Markus-Seitz-OpenBot24/Ampelsteuerung_ET2/Bilder/Image (9).jpg

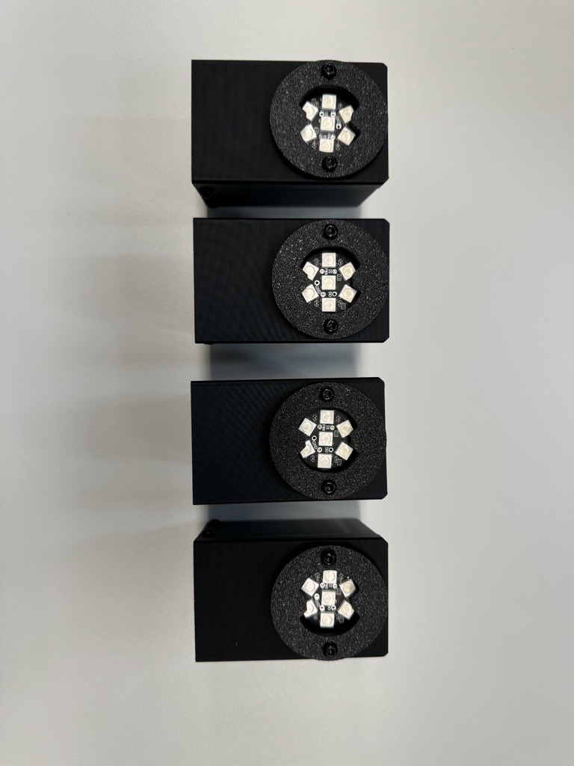
Bilder/Image (9).jpg
