Markus-Seitz-OpenBot24/Ampelsteuerung_ET2/Bilder/Image (19).jpg

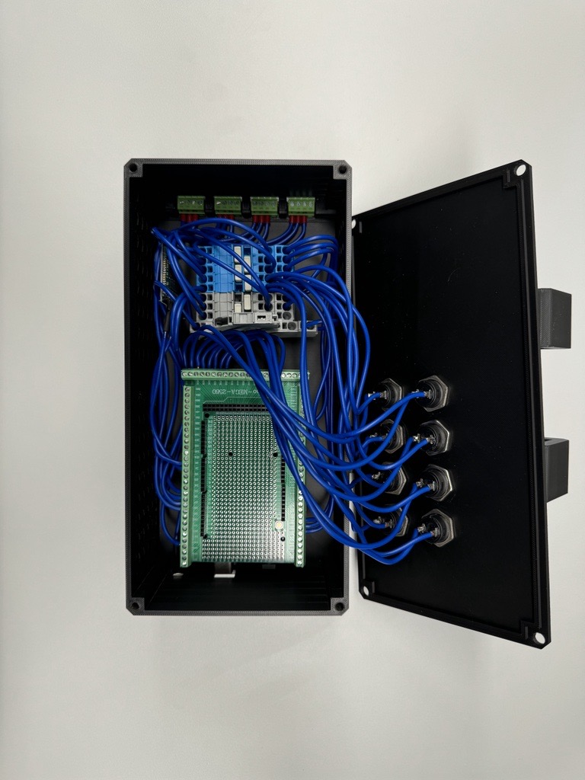
Bilder/Image (19).jpg
