Markus-Seitz-OpenBot24/Ampelsteuerung_ET2/Android_App/ReadME.txt

+ Um die App zur Steuerung der Ampeln nutzen zu können musst du dich zuerst mit dem HC-05 Modul koppeln.

-> hierzu einfach Bluetooth einschalten und nach HC-05 Modul suchen -> zum Koppeln darauf tippen...

+ Jetzt die App öffnen und auf "BT Verbindungen verwalten" klicken

-> HC-05 Modul wählen -> App verbindet sich mit dem Modul

+ Congrats! Jetzt kannst du die Ampeln mit der App steuern!
