Markus-Seitz-OpenBot24/Ampelsteuerung_ET2/Anhang_Ampelsteuerung/Schaltplan/Schaltplan_Ampelsteuerung_Arduino.png

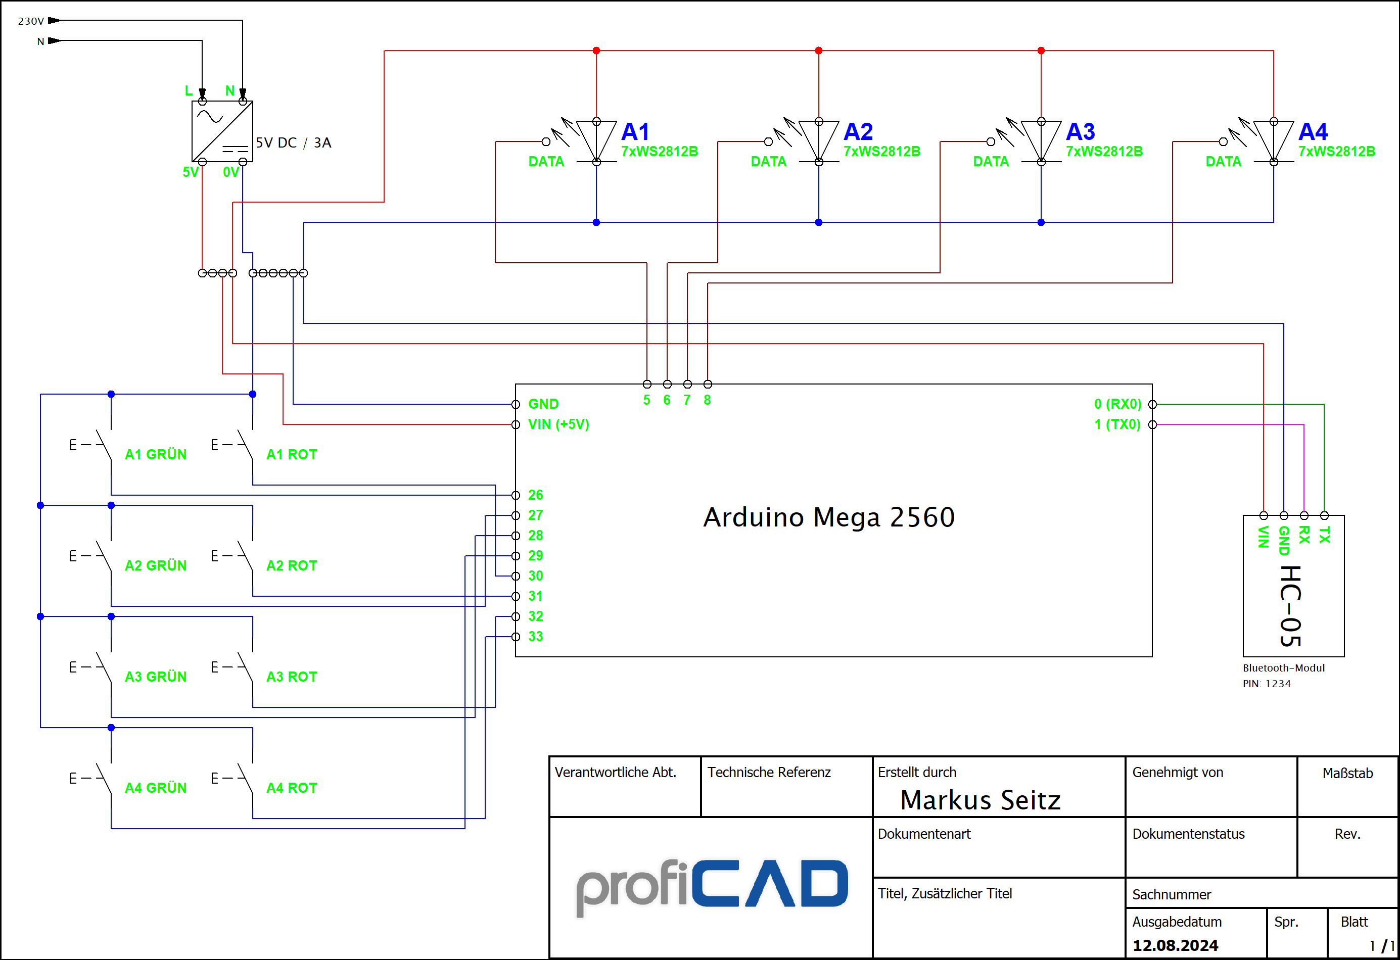
Anhang_Ampelsteuerung/Schaltplan/Schaltplan_Ampelsteuerung_Arduino.png
