Markus-Seitz-OpenBot24/Ampelsteuerung_ET2/Bilder/Ampel.png

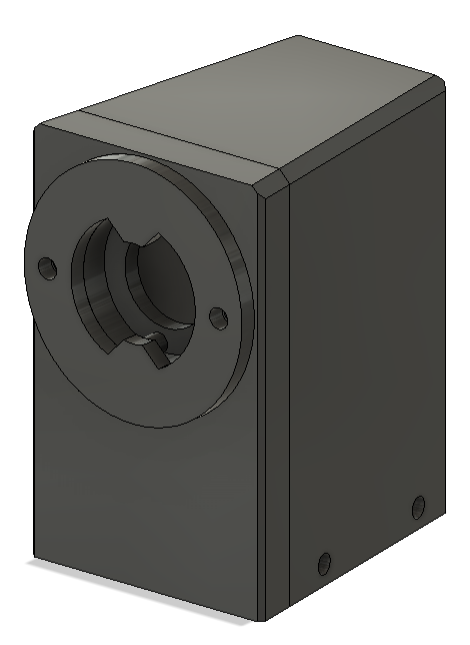
Bilder/Ampel.png
