Markus-Seitz-OpenBot24/Ampelsteuerung_ET2/Bilder/Ampelsteuerung Zeitmanagement/Ampelsteuerung Zeitmanagement_1.png

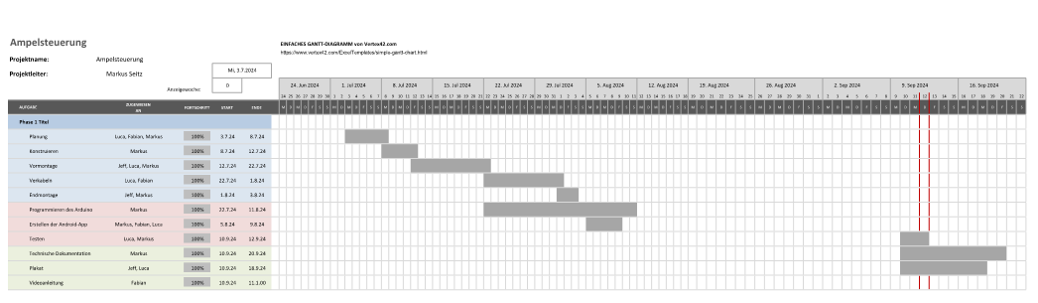
Bilder/Ampelsteuerung Zeitmanagement/Ampelsteuerung Zeitmanagement_1.png
