Markus-Seitz-OpenBot24/Ampelsteuerung_ET2/Bilder/Image (4).jpg

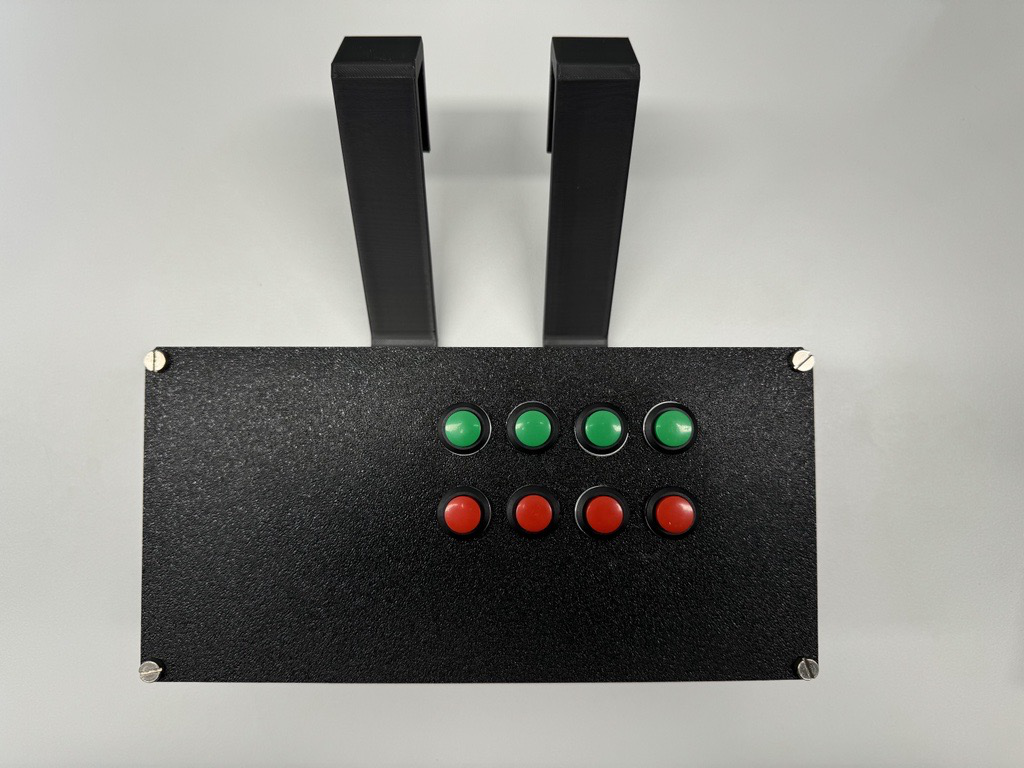
Bilder/Image (4).jpg
