Markus-Seitz-OpenBot24/Ampelsteuerung_ET2/Bilder/Image (8).jpg

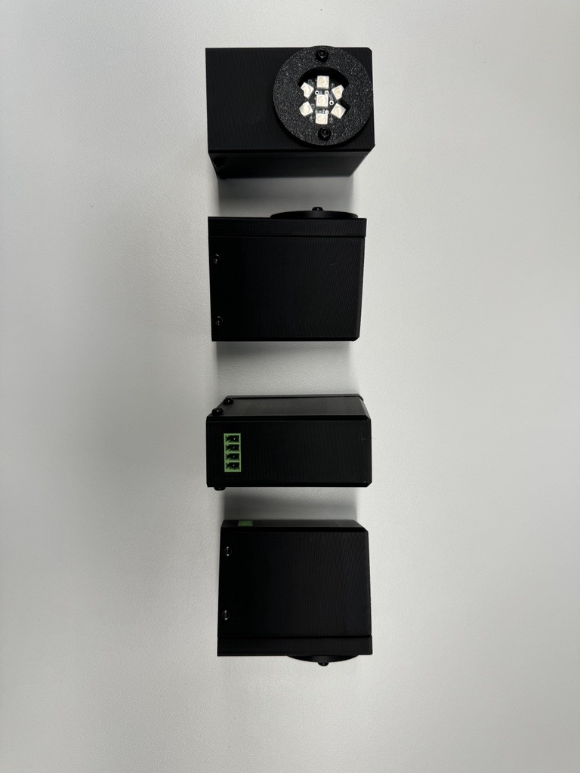
Bilder/Image (8).jpg
