Markus-Seitz-OpenBot24/Ampelsteuerung_ET2/Bilder/Image (11).jpg

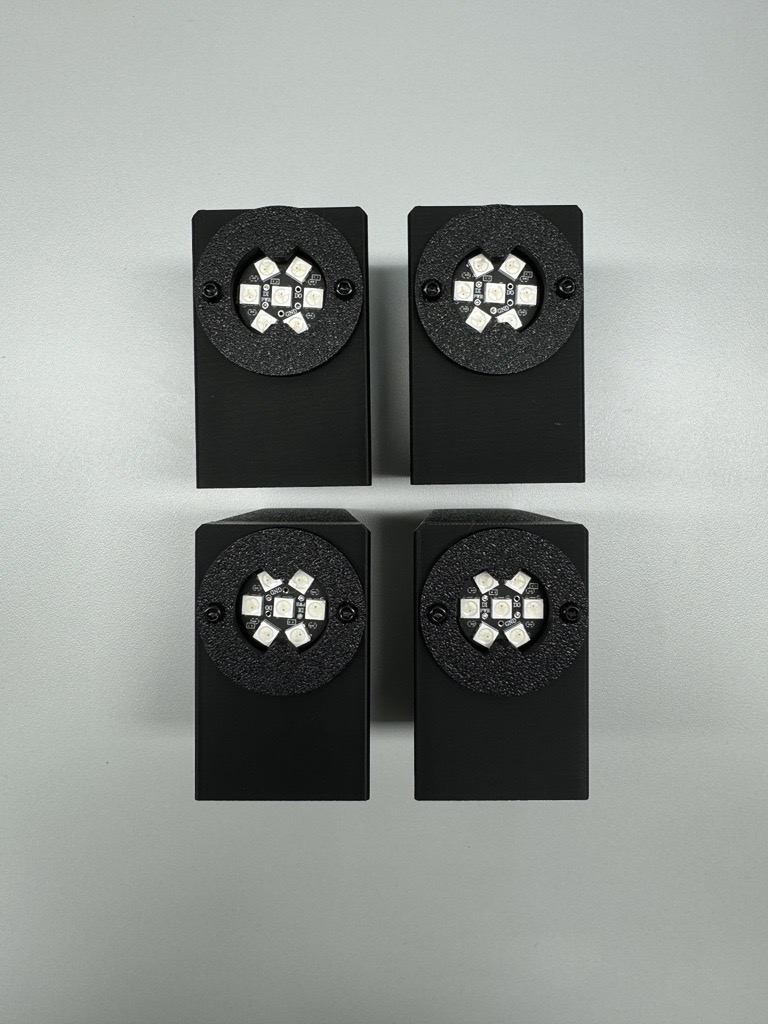
Bilder/Image (11).jpg
