Markus-Seitz-OpenBot24/Ampelsteuerung_ET2/Bilder/Image (13).jpg

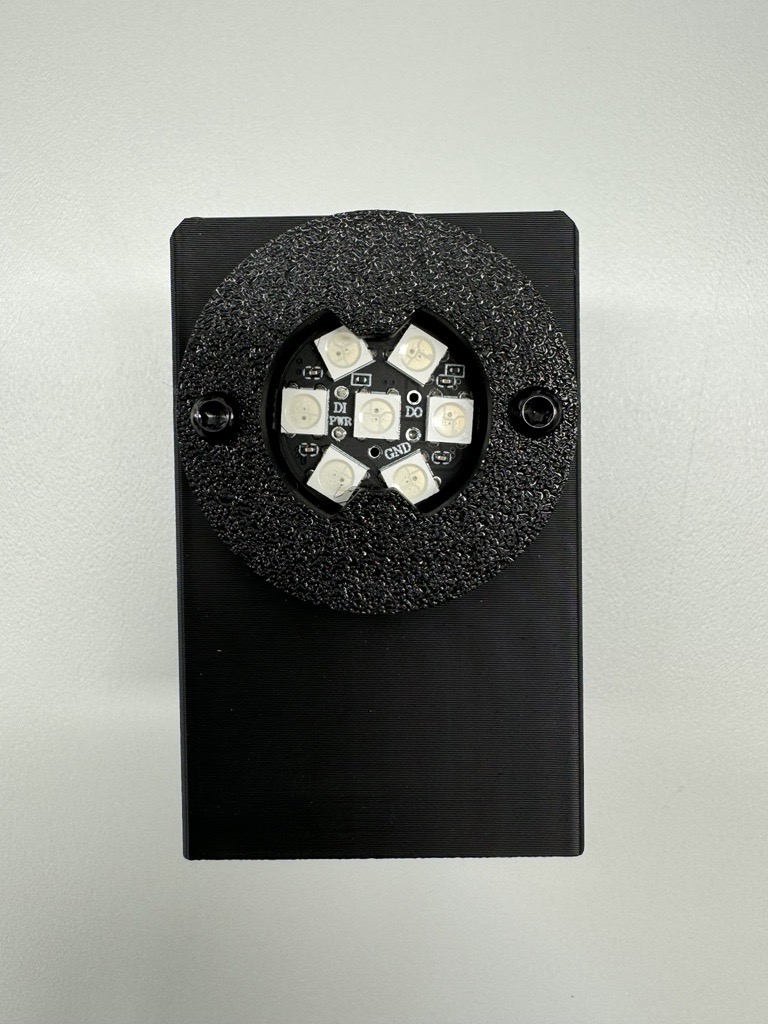
Bilder/Image (13).jpg
