Markus-Seitz-OpenBot24/Ampelsteuerung_ET2/Bilder/Image (18).jpg

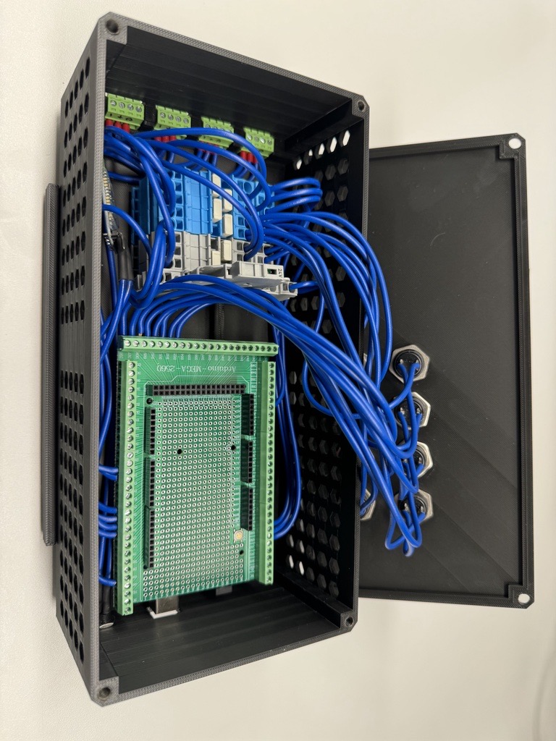
Bilder/Image (18).jpg
