Markus-Seitz-OpenBot24/Ampelsteuerung_ET2/Bilder/Image (20).jpg

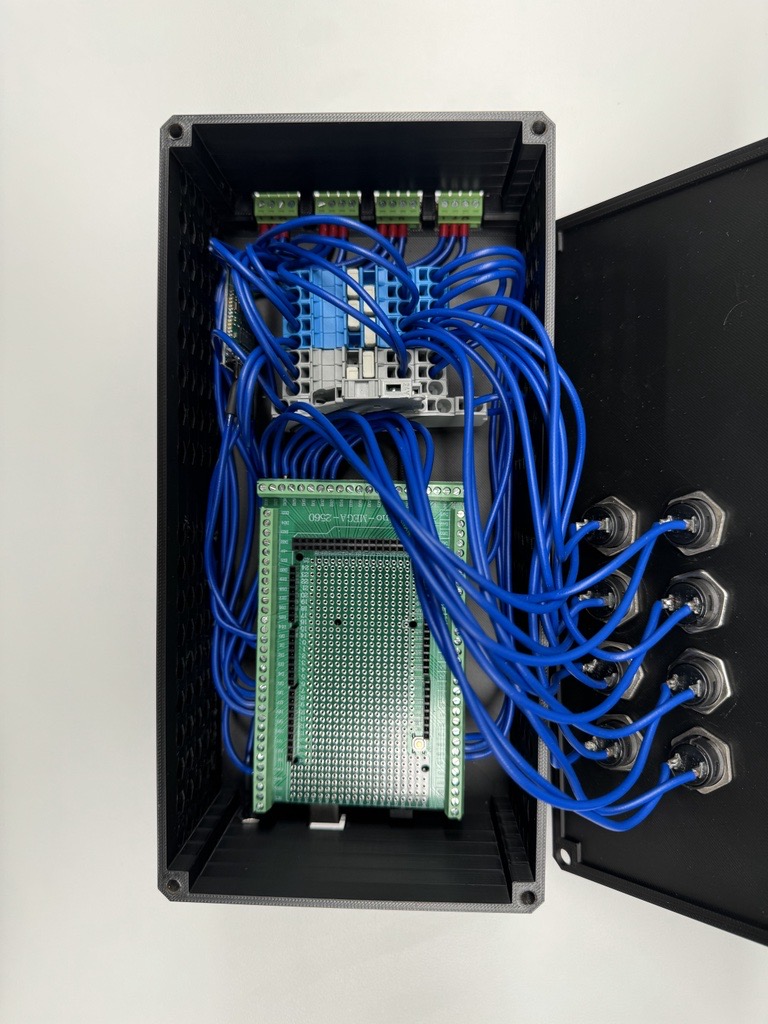
Bilder/Image (20).jpg
