Markus-Seitz-OpenBot24/Ampelsteuerung_ET2/Bilder/Image (21).jpg

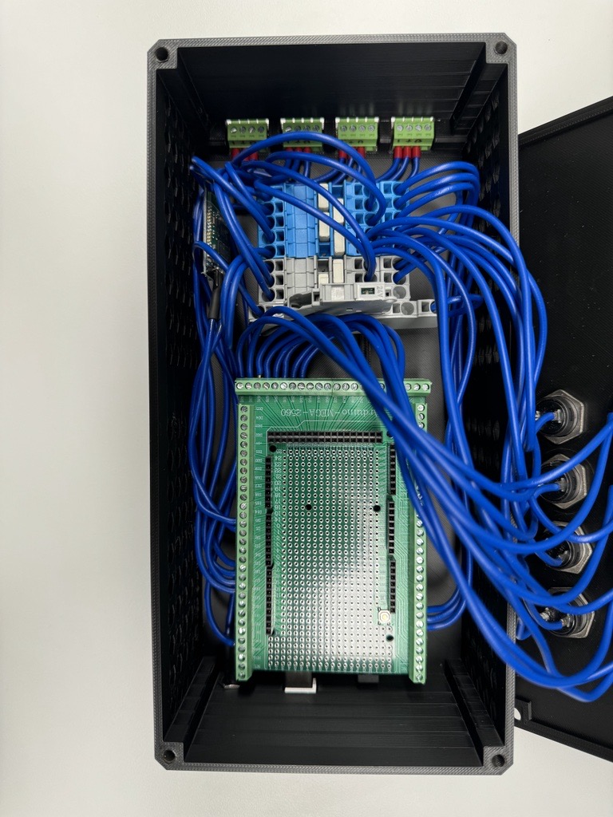
Bilder/Image (21).jpg
