Markus-Seitz-OpenBot24/Ampelsteuerung_ET2/Bilder/Image (28).jpg

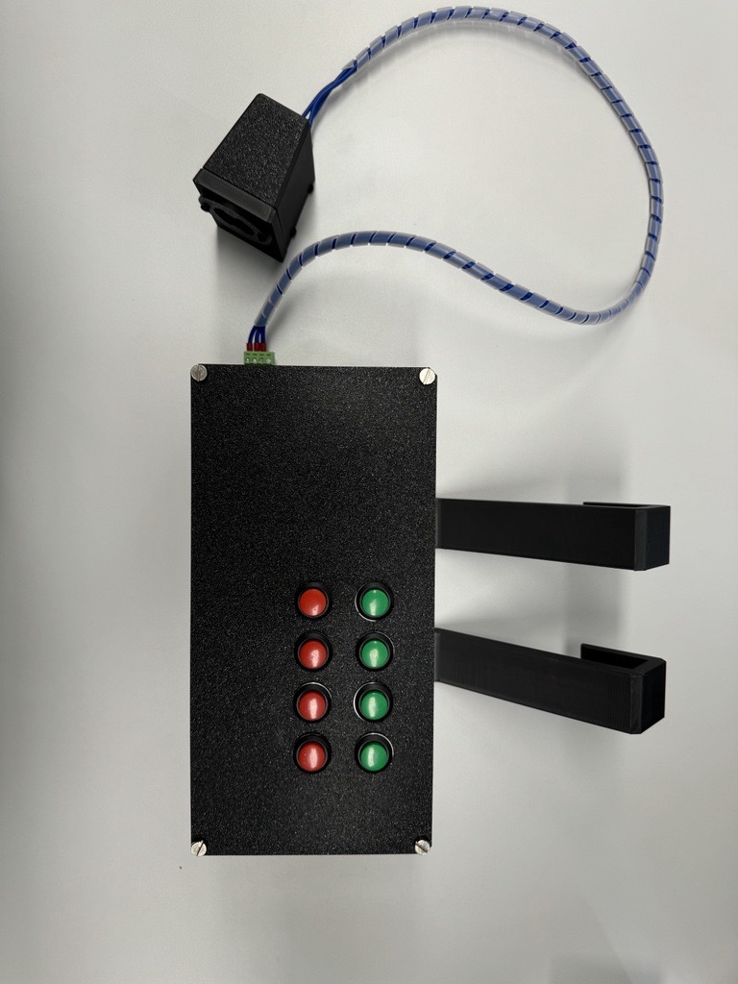
Bilder/Image (28).jpg
