Markus-Seitz-OpenBot24/Ampelsteuerung_ET2/Materialliste/Materialliste_Ampelsteuerung.xlsx

Material | Anzahl | Preis/Stück | Gesamtpreis | Link
Arduino Mega 2560 | 1 | 20 € | 20 € | AZDelivery AZ-MEGA2560-Board mit AZ-MEGA2560-Board inklusive E-Book! : Amazon.de: Computer & Zubehör (https://www.amazon.de/AZDelivery-AZ-MEGA2560-Board-mit-inklusive-Book/dp/B01MCX1CIN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)
HC-05 Bluetooth Shield | 1 | 10 € | 10 € | TECNOULAB 5 Stück HC-05 integriertes Bluetooth-Modul HC05 drahtloses serielles Port-Modul: Amazon.de: Computer & Zubehör (https://www.amazon.de/gp/product/B0C6HZVMJV/ref=ox_sc_act_title_3?smid=A4D0YURZE9ROP&psc=1)
GINTOOYUN 5 - Stil 3 Steckverbinder | 8 | 4 € | 32 € | https://www.amazon.de/gp/product/B0B129S6KC/ref=ox_sc_act_title_1?smid=A2YGO18XVRIAVP&psc=1
WS2812 RGB LED-Ring | 4 | 5 € | 20 € | WS2812 RGB LED-Ring 7 x 5050 WS2812B 7 Bits mit integrierten Treibern für Arduino Raspberry Pi Mirco:bit ESP32, 5 Stück: Amazon.de: Computer & Zubehör (https://www.amazon.de/gp/product/B09K57Y9FL/ref=ox_sc_act_title_2?smid=A32D99AU4SRD9G&psc=1)
Push Buttons | 12 | 1 € | 12 € | 16MM Momentary Push Button on Off Switch Schalter Sortiert Rot Grün Gelb Blau Weiß Schwarz, 3 A 250 V AC 2-poliger selbstrückstellender Mini Rundschalter : Amazon.de: Baumarkt (https://www.amazon.de/Momentary-Schalter-2-poliger-selbstr%C3%BCckstellender-Rundschalter/dp/B09MBQSM44)
Schraubklemmenblock Mega 2560 | 1 | 18 € | 18 € | PENGLIN Zusammengebauter Prototyp Schraubklemmenblock Shield Board Kit für Arduino MEGA 2560 R3 : Amazon.de: Gewerbe, Industrie & Wissenschaft (https://www.amazon.de/dp/B0BB7N2TNQ?psc=1&ref=ppx_yo2ov_dt_b_product_details)
Netzteil 5V/3A | 1 | 13 € | 13 € | AC zu DC 5V 3A Netzteil, Stecker 5,5 mm x 2,1 mm, Plug EU: Amazon.de: Computer & Zubehör (https://www.amazon.de/dp/B0BYS9Y2B6?ref=ppx_yo2ov_dt_b_fed_asin_title)
DC Buchse 5,5mmx2,1mm | 1 | 1.00 € | 1.00 € | 10 Stück DC Buchse 5.5 x 2.1mm 2 Polig DC Power Jack Buchse DC-Einbaubuchse DC Steckverbinder: Amazon.de: Elektronik & Foto (https://www.amazon.de/dp/B09PD6J4BN?ref=ppx_yo2ov_dt_b_fed_asin_title)
Filament / PLA Basic | 1 | 20.00 € | 20.00 €
Sicherungshalter 5x20mm | 1 | 15.00 € | 15.00 € | WAGO 2002-1711/1000-541 Dreistock-Sicherungsklemme 6.20 mm Push-In-Klemme Grau 50 St. kaufen (conrad.de) (https://www.conrad.de/de/p/wago-2002-1711-1000-541-dreistock-sicherungsklemme-6-20-mm-push-in-klemme-grau-50-st-1931597.html)
 |  |  | 0
 |  |  | 0
 |  |  | 0
 |  |  | 0
 |  |  | 0
 |  |  | 0
 |  |  | 0
 |  |  | 0
 |  |  | 0
 |  |  | 0
 |  |  | 0 | 0
Gesamtpreis Material: |  |  | 161 €
