Markus-Seitz-OpenBot24/Ampelsteuerung_ET2/Anhang_Ampelsteuerung/CAD_Daten/Gehäuse_Ampel/Gehäuse_Ampel_Arduino.step

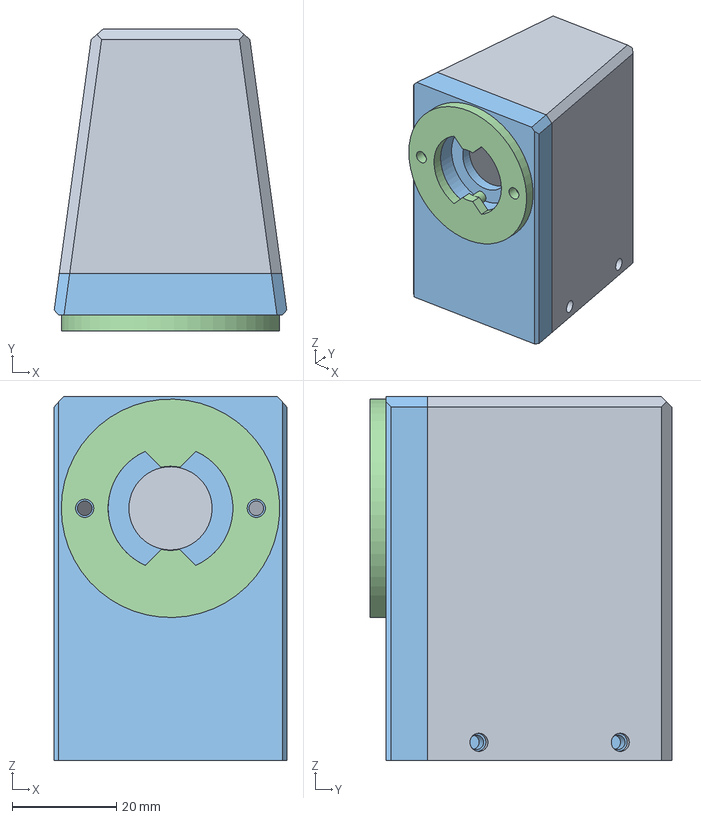
[picture p39: CAD file, 2024-09-17]
Anhang_Ampelsteuerung/CAD_Daten/Gehäuse_Ampel/Gehäuse_Ampel_Arduino.step
44.7 x 58.0 x 70.0 mm
Heck
Bügel
Front
LED_Halter
