Markus-Seitz-OpenBot24/Ampelsteuerung_ET2/Anhang_Ampelsteuerung/CAD_Daten/Haltebügel/Haltebügel_Ampelsteuerung.step

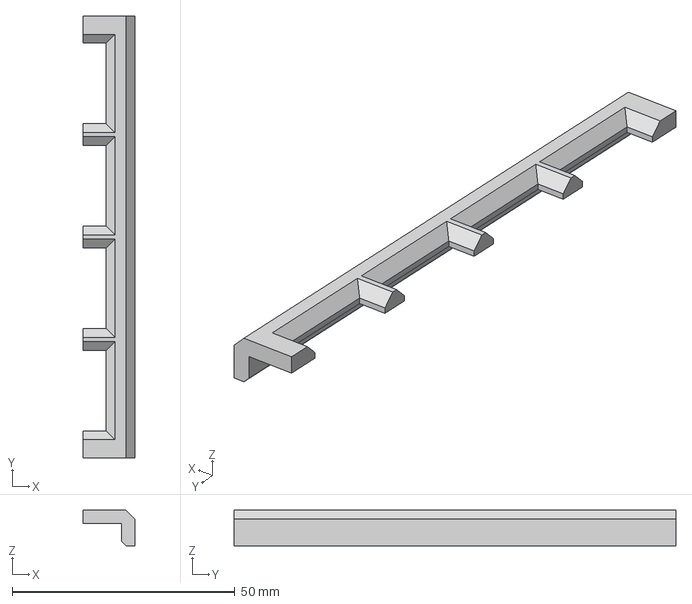
[picture p40: CAD file, 2024-09-18]
Anhang_Ampelsteuerung/CAD_Daten/Haltebügel/Haltebügel_Ampelsteuerung.step
11.6 x 99.2 x 8.00 mm
