Markus-Seitz-OpenBot24/Ampelsteuerung_ET2/(list of files, cad)

Other CAD files:
Anhang_Ampelsteuerung/CAD_Daten/Gehäuse_Ampel/Gehäuse_Ampel_Arduino.f3d
Anhang_Ampelsteuerung/CAD_Daten/Haltebügel/Haltebügel_Ampelsteuerung.f3d
CAD_Daten/Gehäuse_Ampel_Arduino.f3d
CAD_Daten/Haltebügel_Ampelsteuerung.f3d
